n1LS/OSL120557060/pcb/OSL120557060.kicad_pcb

## KiCad design pcb/OSL120557060.kicad_pcb (2019-07-12)

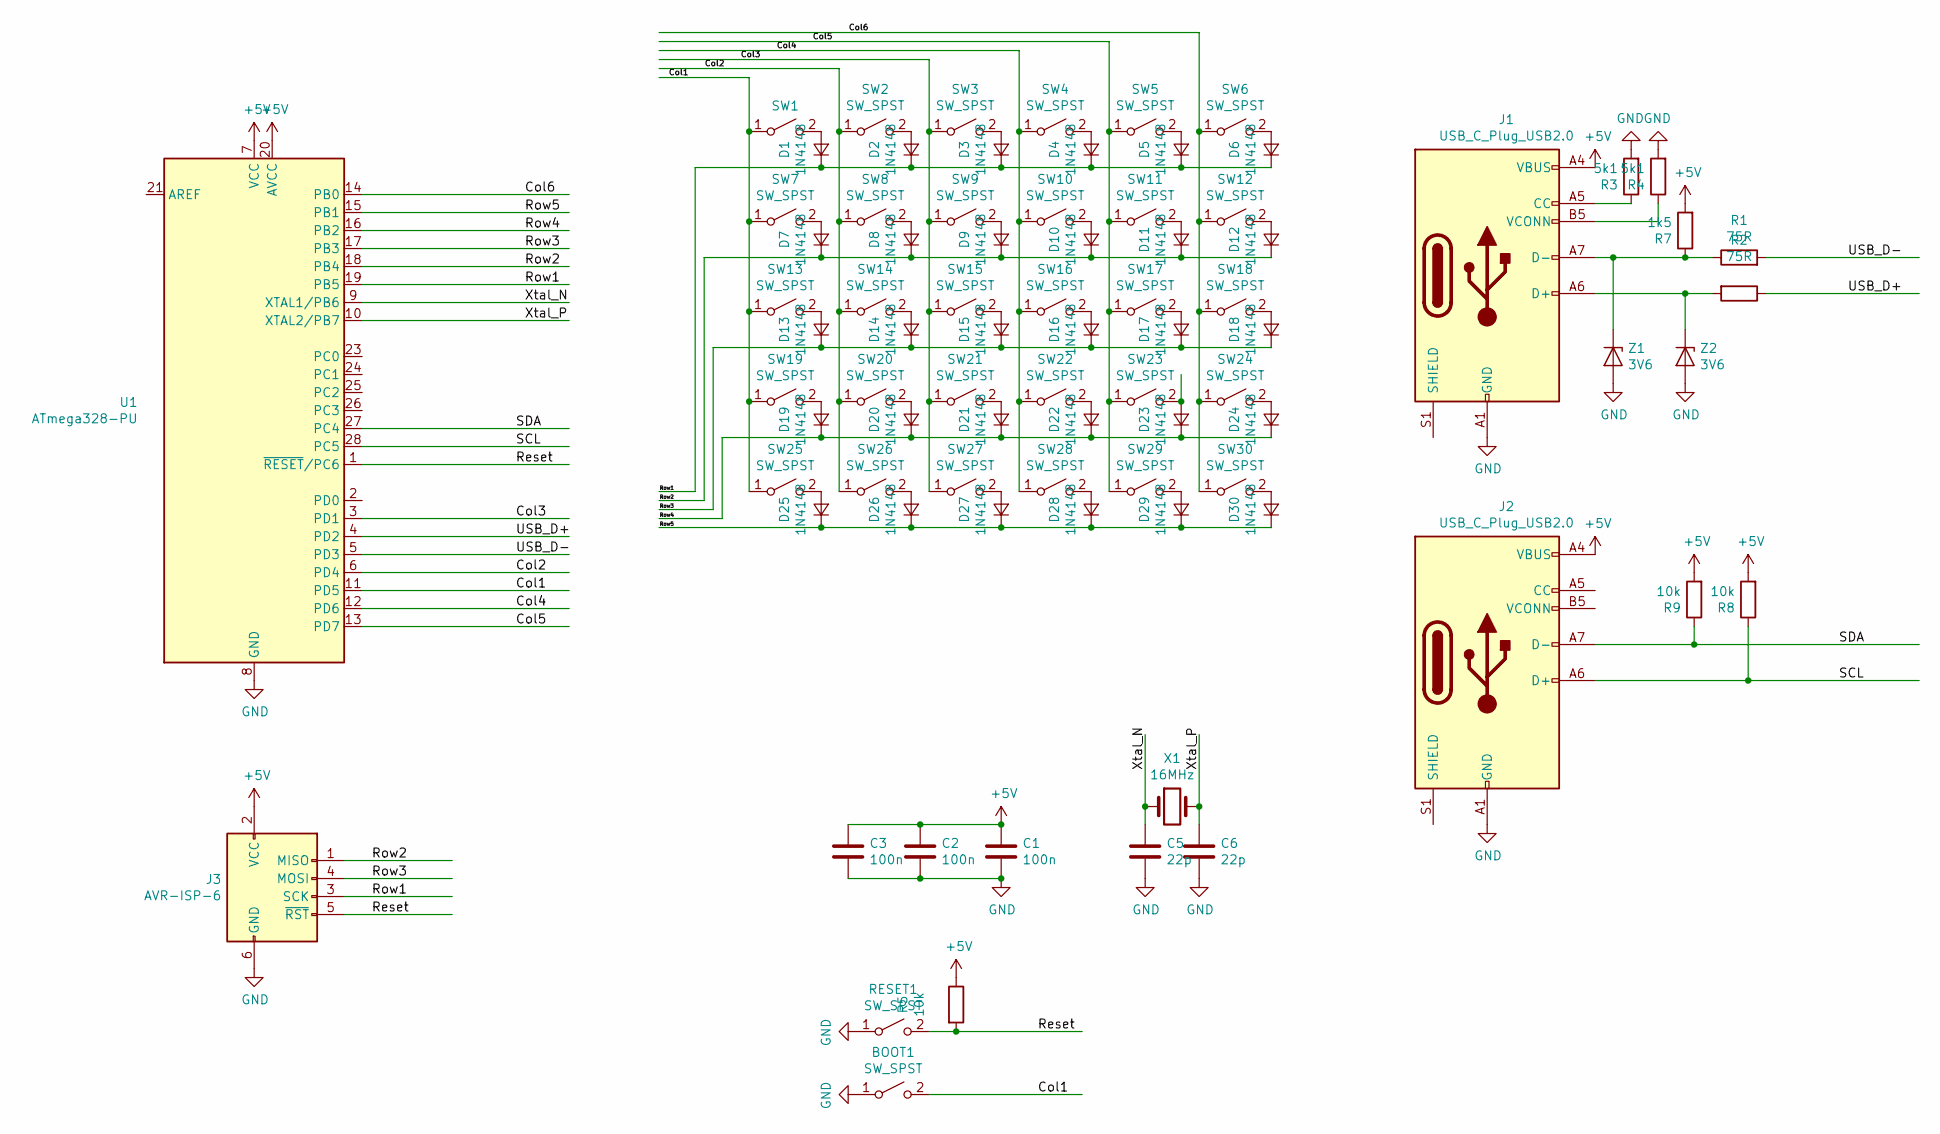
[picture p1: schematic OSL120557060.sch]

Parts:
BOOT1: SW_SPST; SW_SPST_B3U-1000P
C1, C2, C3: 100n; C_Disc_D3.0mm_W1.6mm_P2.50mm
C5, C6: 22p; C_Disc_D3.0mm_W1.6mm_P2.50mm
D1, D2, D3, D4, D5, D6, D7, D8, D9, D10, D11, D12, D13, D14, D15, D16, D17, D18, D19, D20, D21, D22, D23, D24, D25, D26, D27, D28, D29, D30: 1N4148; D_T-1_P5.08mm_Horizontal
J1, J2: USB_C_Plug_USB2.0; USB_C_Receptacle_GCT_USB4085
J3: AVR-ISP-6; PinHeader_2x03_P2.54mm_Vertical
R1, R2: 75R; R_Axial_DIN0207_L6.3mm_D2.5mm_P7.62mm_Horizontal
R3, R4: 5k1; R_Axial_DIN0207_L6.3mm_D2.5mm_P7.62mm_Horizontal
R5, R8, R9: 10k; R_Axial_DIN0207_L6.3mm_D2.5mm_P7.62mm_Horizontal
R7: 1k5; R_Axial_DIN0207_L6.3mm_D2.5mm_P7.62mm_Horizontal
RESET1: SW_SPST; SW_SPST_B3U-1000P
SW1, SW2, SW3, SW4, SW5, SW6, SW7, SW8, SW9, SW10, SW11, SW12, SW13, SW14, SW15, SW16, SW17, SW18, SW19, SW20, SW21, SW22, SW23, SW24, SW25, SW26, SW27, SW28, SW29, SW30: SW_SPST; SW_Cherry_MX_1.00u_Plate
U1: ATmega328-PU; DIP-28_W7.62mm
X1: 16MHz; Crystal_HC49-4H_Vertical
Z1, Z2: 3V6; D_T-1_P5.08mm_Horizontal

Connections:
+5V: C1.1, C2.1, C3.1, J1.A4 (VBUS), J1.A9 (VBUS), J1.B4 (VBUS), J1.B9 (VBUS), J2.A4 (VBUS), J2.A9 (VBUS), J2.B4 (VBUS), J2.B9 (VBUS), J3.2 (VCC), R5.1, R7.2, R8.2, R9.2, U1.7 (VCC), U1.20 (AVCC)
/Col1: BOOT1.2 (B), SW1.1 (A), SW7.1 (A), SW13.1 (A), SW19.1 (A), SW25.1 (A), U1.11 (PD5); also elsewhere on the board
/Col2: SW2.1 (A), SW8.1 (A), SW14.1 (A), SW20.1 (A), SW26.1 (A), U1.6 (PD4)
/Col3: SW3.1 (A), SW9.1 (A), SW15.1 (A), SW21.1 (A), SW27.1 (A), U1.3 (PD1)
/Col4: SW4.1 (A), SW10.1 (A), SW16.1 (A), SW22.1 (A), SW28.1 (A), U1.12 (PD6)
/Col5: SW5.1 (A), SW11.1 (A), SW17.1 (A), SW23.1 (A), SW29.1 (A), U1.13 (PD7)
/Col6: SW6.1 (A), SW12.1 (A), SW18.1 (A), SW24.1 (A), SW30.1 (A), U1.14 (PB0)
/Reset: J3.5 (~RST), R5.2, RESET1.2 (B), U1.1 (~RESET~/PC6); also elsewhere on the board
/Row1: D1.1 (K), D2.1 (K), D3.1 (K), D4.1 (K), D5.1 (K), D6.1 (K), J3.3 (SCK), U1.19 (PB5)
/Row2: D7.1 (K), D8.1 (K), D9.1 (K), D10.1 (K), D11.1 (K), D12.1 (K), J3.1 (MISO), U1.18 (PB4)
/Row3: D13.1 (K), D14.1 (K), D15.1 (K), D16.1 (K), D17.1 (K), D18.1 (K), J3.4 (MOSI), U1.17 (PB3)
/Row4: D19.1 (K), D20.1 (K), D21.1 (K), D22.1 (K), D23.1 (K), D24.1 (K), U1.16 (PB2)
/Row5: D25.1 (K), D26.1 (K), D27.1 (K), D28.1 (K), D29.1 (K), D30.1 (K), U1.15 (PB1)
/SCL: J2.A6 (D+), R8.1, U1.28 (PC5)
/SDA: J2.A7 (D-), R9.1, U1.27 (PC4)
/USB_D+: R2.1, U1.4 (PD2)
/USB_D-: R1.2, U1.5 (PD3)
/Xtal_N: C5.1, U1.9 (XTAL1/PB6), X1.1
/Xtal_P: C6.1, U1.10 (XTAL2/PB7), X1.2
GND: BOOT1.1 (A), C1.2, C2.2, C3.2, C5.2, C6.2, J1.A1 (GND), J1.A12 (GND), J1.B1 (GND), J1.B12 (GND), J2.A1 (GND), J2.A12 (GND), J2.B1 (GND), J2.B12 (GND), J3.6 (GND), R3.2, R4.2, RESET1.1 (A), U1.8 (GND), U1.22 (GND), Z1.2 (A), Z2.2 (A); also elsewhere on the board
unnamed: D1.2 (A), SW1.2 (B)
unnamed: D2.2 (A), SW2.2 (B)
unnamed: D3.2 (A), SW3.2 (B)
unnamed: D4.2 (A), SW4.2 (B)
unnamed: D5.2 (A), SW5.2 (B)
unnamed: D6.2 (A), SW6.2 (B)
unnamed: D7.2 (A), SW7.2 (B)
unnamed: D8.2 (A), SW8.2 (B)
unnamed: D9.2 (A), SW9.2 (B)
unnamed: D10.2 (A), SW10.2 (B)
unnamed: D11.2 (A), SW11.2 (B)
unnamed: D12.2 (A), SW12.2 (B)
unnamed: D13.2 (A), SW13.2 (B)
unnamed: D14.2 (A), SW14.2 (B)
unnamed: D15.2 (A), SW15.2 (B)
unnamed: D16.2 (A), SW16.2 (B)
unnamed: D17.2 (A), SW17.2 (B)
unnamed: D18.2 (A), SW18.2 (B)
unnamed: D19.2 (A), SW19.2 (B)
unnamed: D20.2 (A), SW20.2 (B)
unnamed: D21.2 (A), SW21.2 (B)
unnamed: D22.2 (A), SW22.2 (B)
unnamed: D23.2 (A), SW23.2 (B)
unnamed: D24.2 (A), SW24.2 (B)
unnamed: D25.2 (A), SW25.2 (B)
unnamed: D26.2 (A), SW26.2 (B)
unnamed: D27.2 (A), SW27.2 (B)
unnamed: D28.2 (A), SW28.2 (B)
unnamed: D29.2 (A), SW29.2 (B)
unnamed: D30.2 (A), SW30.2 (B)
unnamed: J1.A5 (CC), R3.1
unnamed: J1.A6 (D+), R2.2, Z2.1 (K)
unnamed: J1.A7 (D-), R1.1, R7.1, Z1.1 (K)
unnamed: J1.B5 (VCONN), R4.1

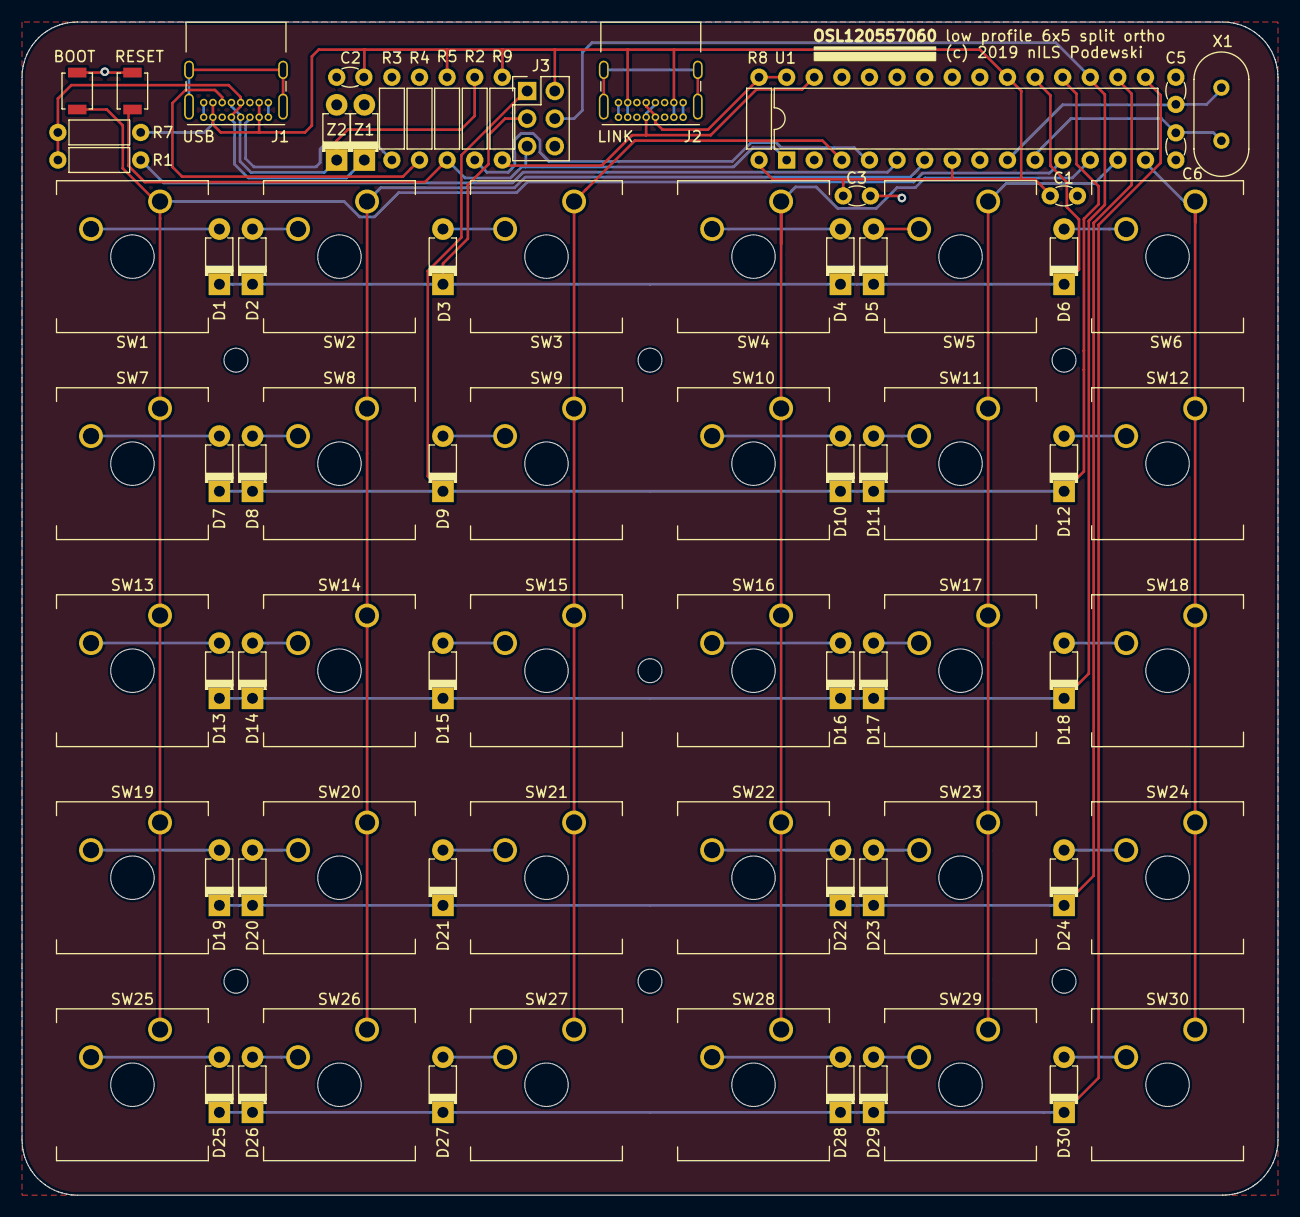
[picture p2: board OSL120557060.kicad_pcb from above]

Board: 2 copper layers, 115.6 x 108.0 mm, 82 parts (0 on the bottom side), 54 nets.

Other parts of the board:
BOOT: SW_SPST; SW_SPST_B3U-1000P
RESET: SW_SPST; SW_SPST_B3U-1000P

Their connections:
/Col1: BOOT.2; also elsewhere on the board
/Reset: RESET.2; also elsewhere on the board
GND: BOOT.1, RESET.1; also elsewhere on the board
