n1LS/OSL120557060/(commit log)

2019-06-20 added missing reset switch
    [OSL120557060.kicad_pcb]
2019-06-20 updated schematic with reset switch
    [OSL120557060.sch]
2019-06-21 added smaller reset switches moved components to allow for all around plate
    [OSL120557060.kicad_pcb, OSL120557060.sch]
2019-06-21 changed component footprints
    [OSL120557060.sch]
2019-06-24 * added plate pcb * fixed reset button placement
    [OSL120557060_plate.kicad_pcb, OSL120557060_plate.sch]
2019-06-24 * added missing zener diodes on the usb port
    [OSL120557060.kicad_pcb, OSL120557060.sch]
2019-06-27 moved from micro usb to usb-c (yw wilba)
    [OSL120557060.kicad_pcb, OSL120557060.sch]
2019-07-08 * added mount pis to pcb * improved plate layout
    [OSL120557060.kicad_pcb, OSL120557060.sch, OSL120557060_plate.kicad_pcb]
2019-07-09 * added pulldown resistors to allow usb-c usb-c cables * fixed usb-c footprint for reversibility
    [OSL120557060.kicad_pcb, OSL120557060.sch]
2019-07-10 silkscreen updates
    [OSL120557060.kicad_pcb]
2019-07-12 - added first revision BOM - improved base layout for plates
    [OSL120557060.kicad_pcb]
