n1LS/OSL120557060/(notices)

Notices in the files:
pcb/OSL120557060.kicad_pcb:
(c) 2019 nILS Podewski
